Sage-Grouse/WiFi_ESP32_Coop_Door/images/ESP32_Coop_Door_web_2.PNG

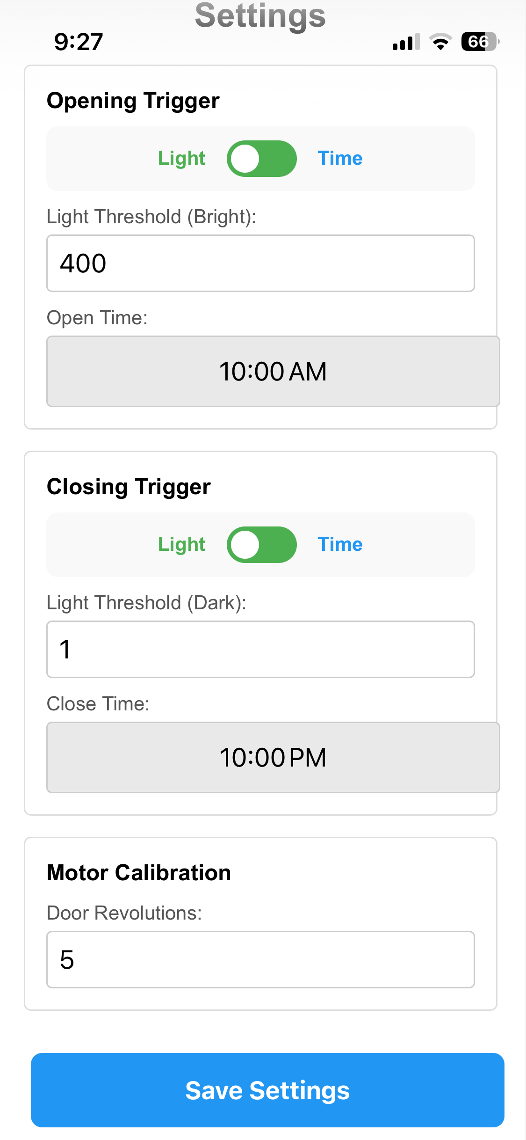
images/ESP32_Coop_Door_web_2.PNG
