Sage-Grouse/WiFi_ESP32_Coop_Door/stl files/Coop Door Text.stl

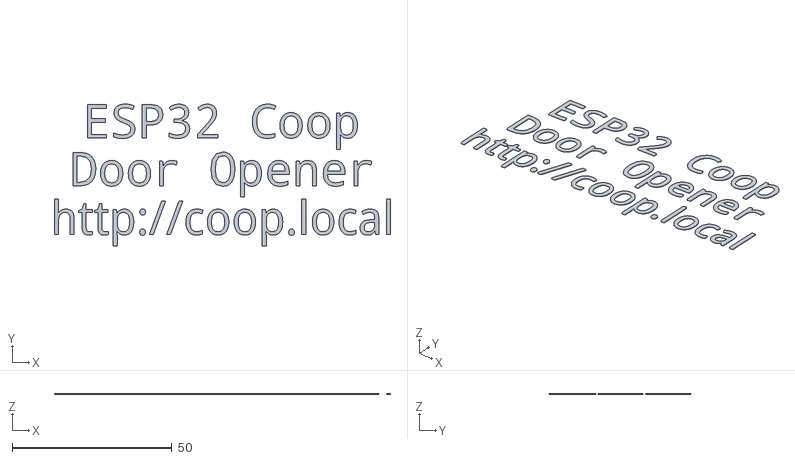
[picture p6: CAD file, 2026-10-12]
stl files/Coop Door Text.stl
105.2 x 44.4 x 0.4
