Sage-Grouse/WiFi_ESP32_Coop_Door/stl files/Spool.stl

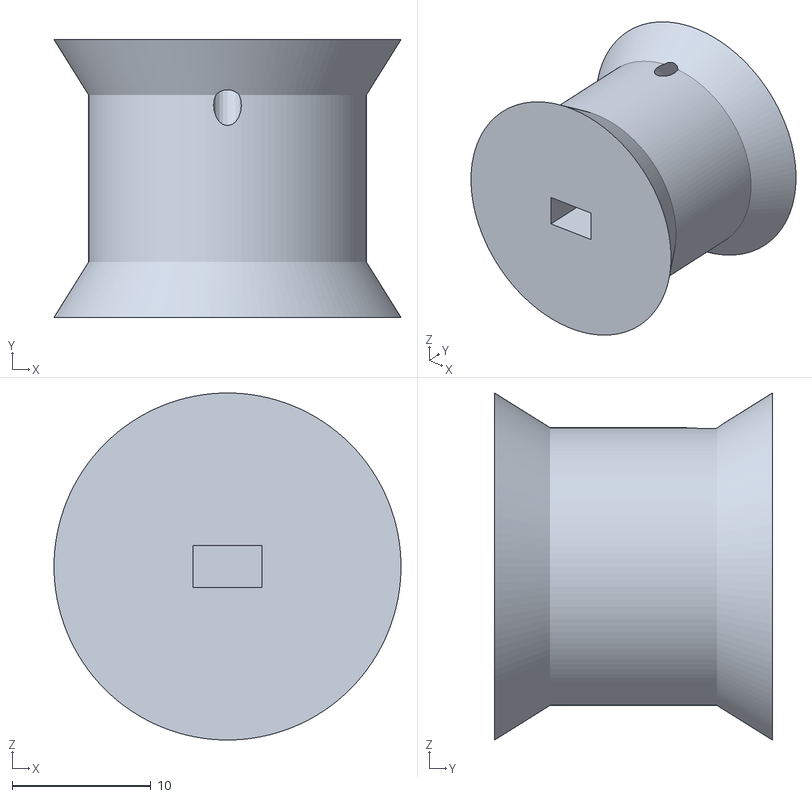
[picture p7: CAD file, 2026-10-12]
stl files/Spool.stl
25.0 x 20.0 x 25.0
