Sage-Grouse/WiFi_ESP32_Coop_Door/stl files/Coop Door Bottom.stl

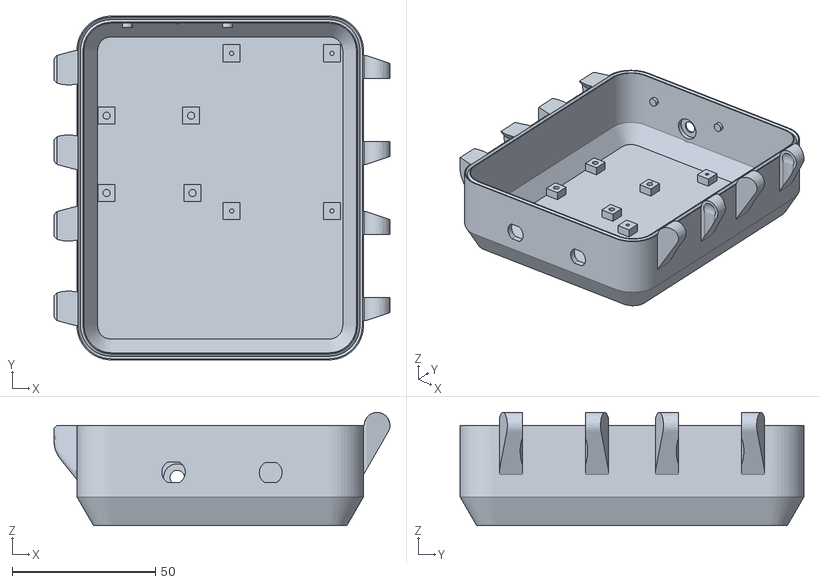
[picture p8: CAD file, 2026-10-12]
stl files/Coop Door Bottom.stl
117.3 x 120.0 x 39.5
