Sage-Grouse/WiFi_ESP32_Coop_Door/stl files/Photoresistor Holder.stl

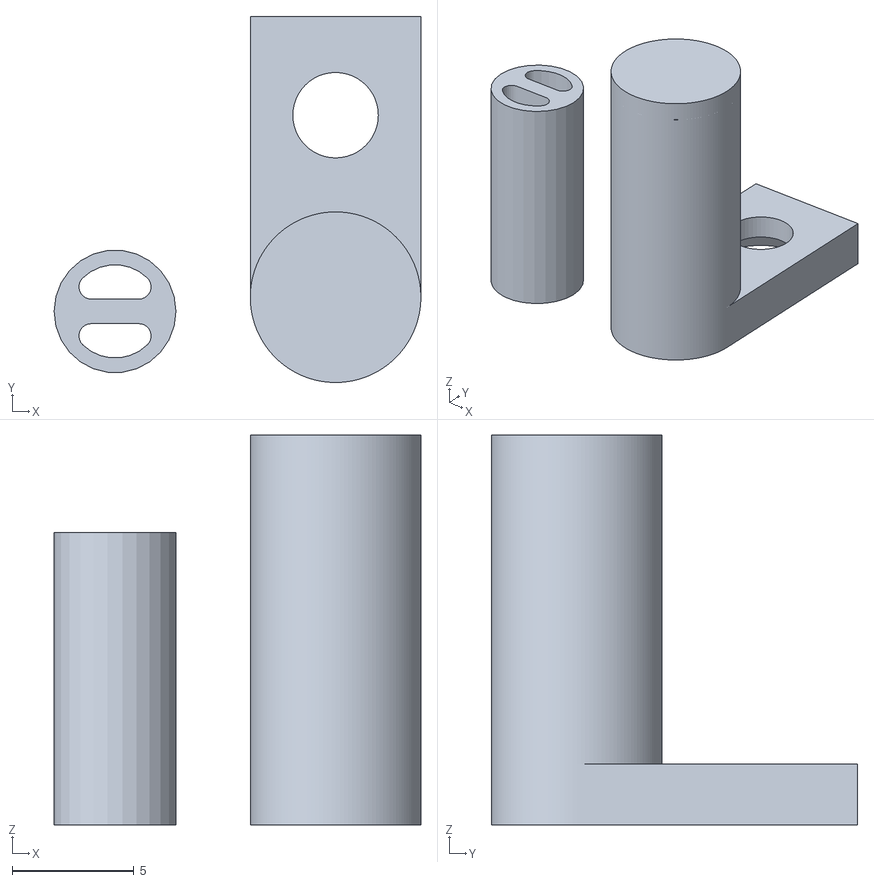
[picture p9: CAD file, 2026-10-12]
stl files/Photoresistor Holder.stl
15.0 x 15.0 x 16.0
