Sage-Grouse/WiFi_ESP32_Coop_Door/stl files/Coop Door Top.stl

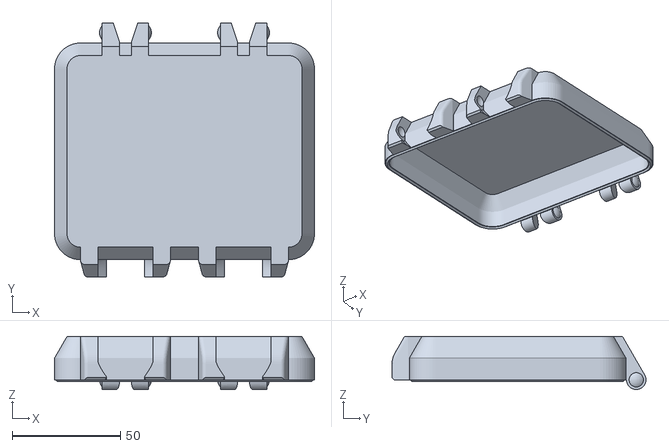
[picture p10: CAD file, 2026-10-12]
stl files/Coop Door Top.stl
120.0 x 117.2 x 24.5
